Spackstor/Ant-Rot/AntRotAss.pdf

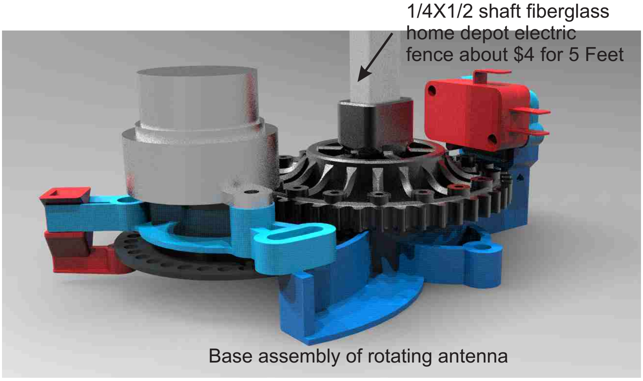
[picture p1: page 1]

Base assembly of rotating antenna

1/4X1/2 shaft fiberglass
home depot electric
fence about $4 for 5 Feet

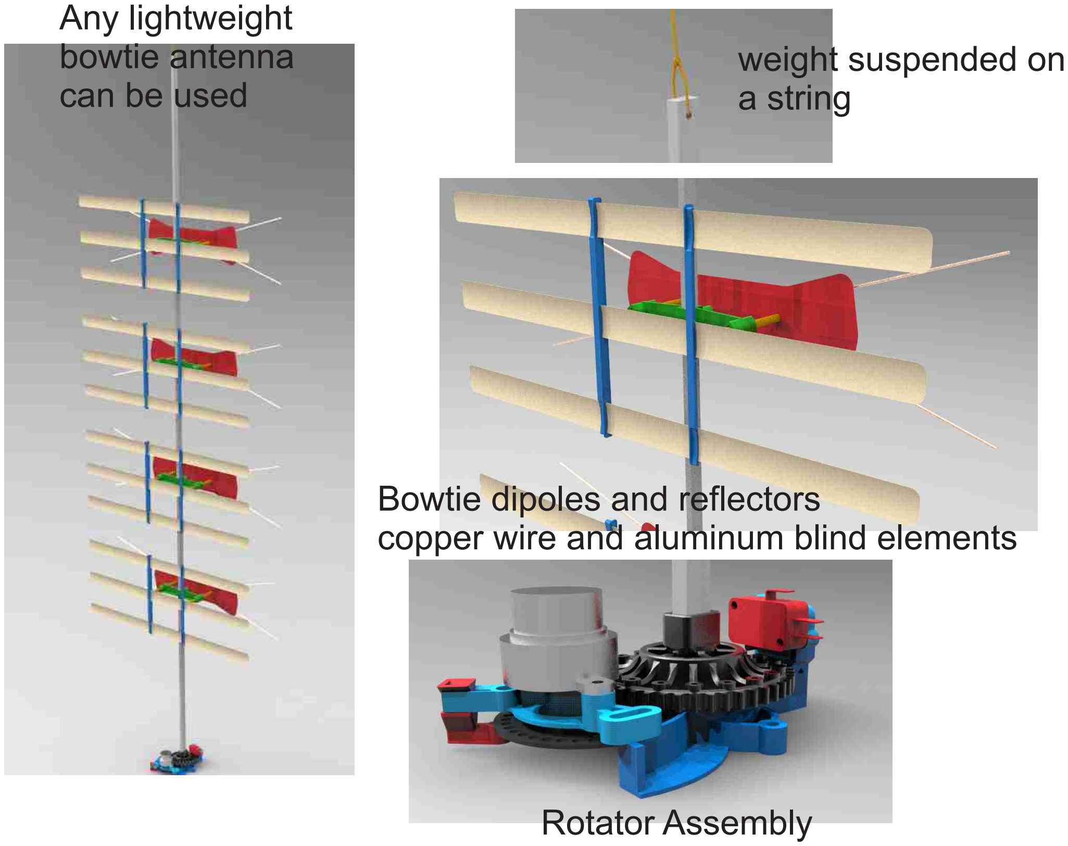
[picture p2: page 2]

Rotator Assembly

Bowtie dipoles and reflectors
copper wire and aluminum blind elements

weight suspended on
a string

Any lightweight
bowtie antenna
can be used

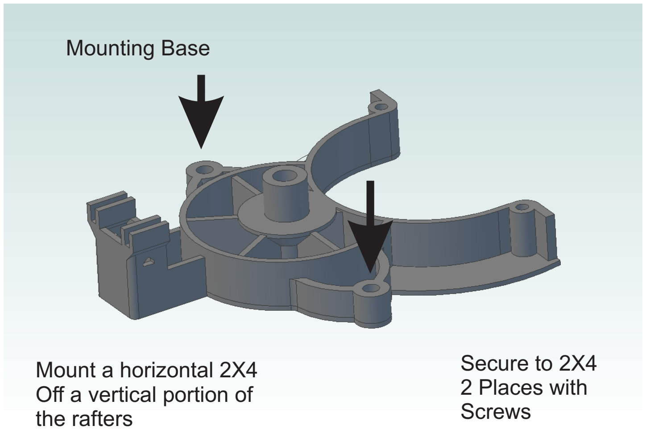
[picture p3: page 3]

Mounting Base

Mount a horizontal 2X4
Off a vertical portion of
the rafters

Secure to 2X4
2 Places with
Screws

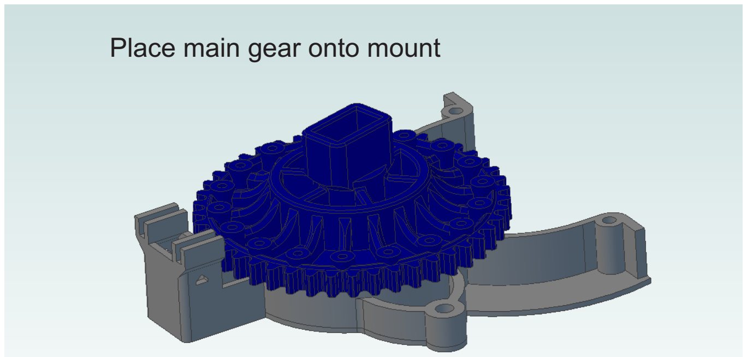
[picture p4: page 4]

Place main gear onto mount

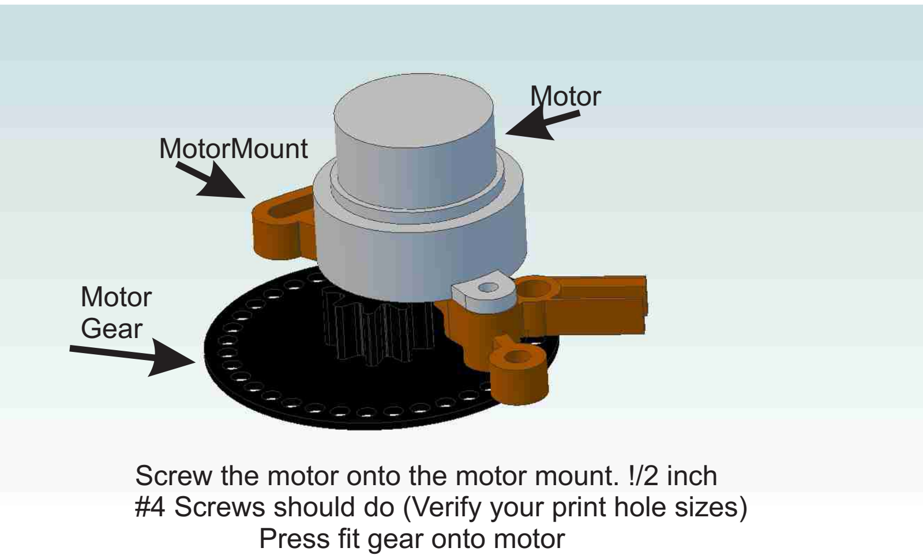
[picture p5: page 5]

Motor

MotorMount

Motor
Gear

Screw the motor onto the motor mount. !/2 inch #4 Screws should do (Verify your print hole sizes) Press fit gear onto motor

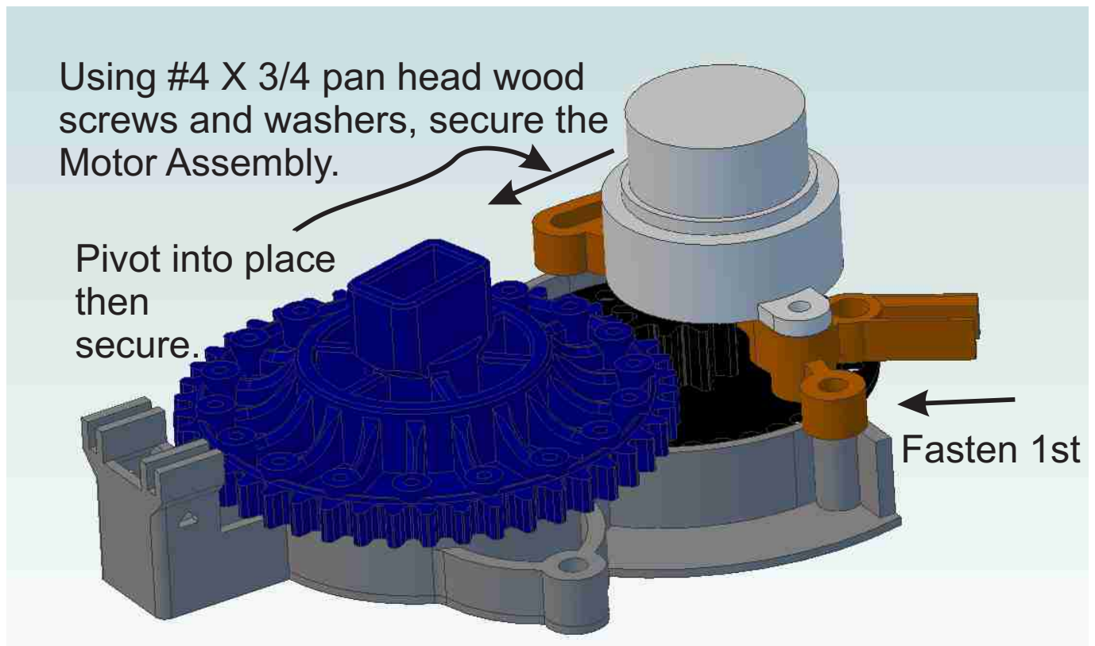
[picture p6: page 6]

Using #4 X 3/4 pan head wood screws and washers, secure the Motor Assembly.

Fasten 1st

Pivot into place
then
secure.

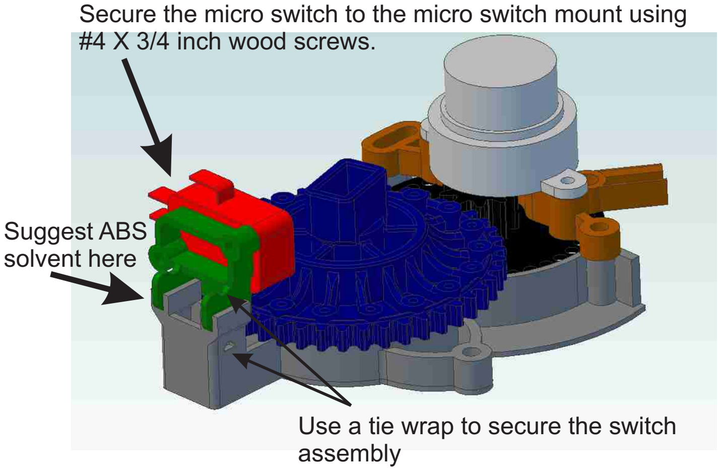
[picture p7: page 7]

Secure the micro switch to the micro switch mount using #4 X 3/4 inch wood screws.

Suggest ABS
solvent here

Use a tie wrap to secure the switch assembly

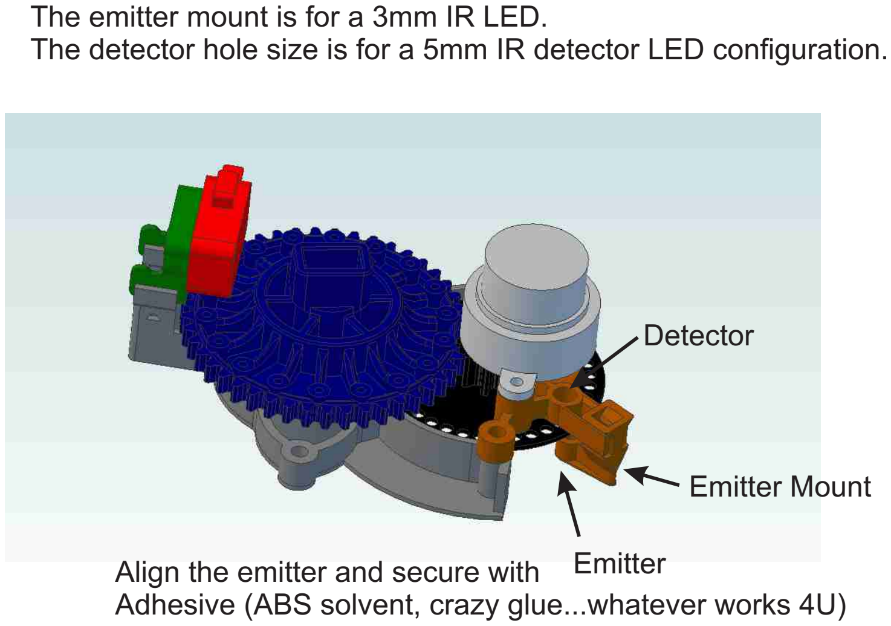
[picture p8: page 8]

Emitter Mount

The emitter mount is for a 3mm IR LED.
The detector hole size is for a 5mm IR detector LED configuration.

Detector

Align the emitter and secure with Emitter
Adhesive (ABS solvent, crazy glue...whatever works 4U)

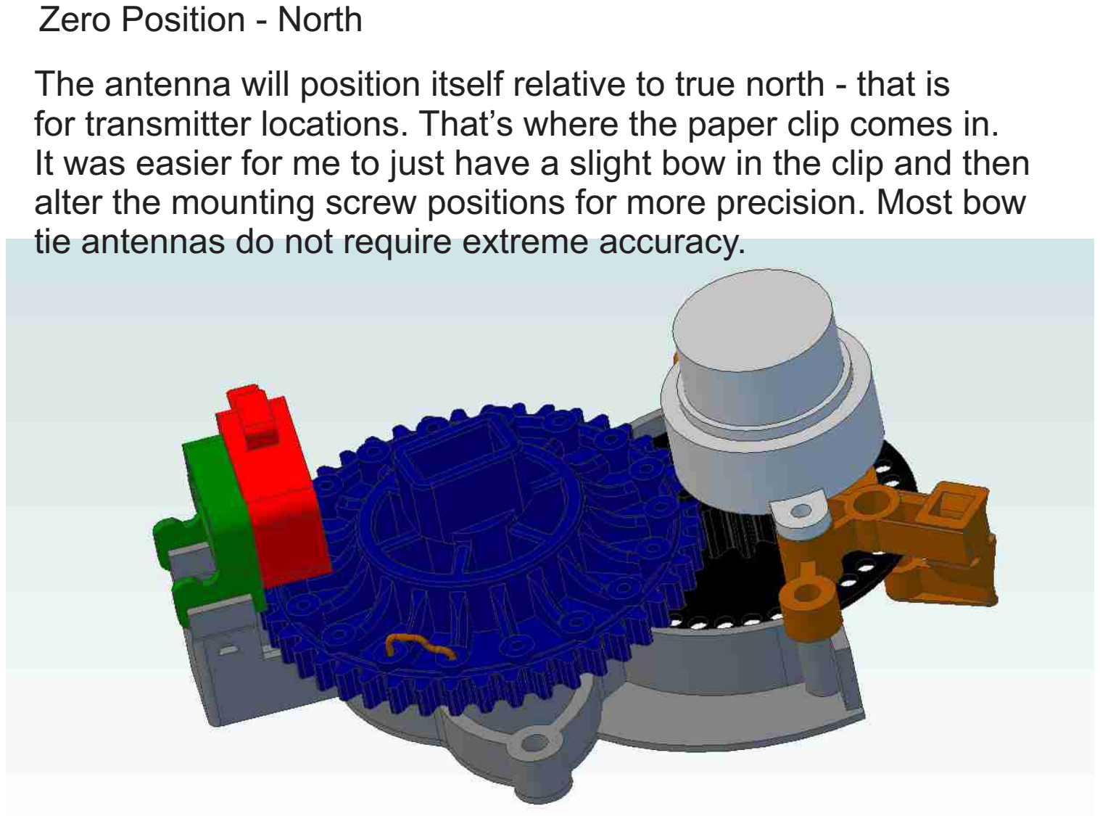
[picture p9: page 9]

Zero Position - North

The antenna will position itself relative to true north - that is
for transmitter locations. That’s where the paper clip comes in. It was easier for me to just have a slight bow in the clip and then alter the mounting screw positions for more precision. Most bow tie antennas do not require extreme accuracy.

Screw sizes will depend on your 3D print. So make first and get screws later. My setup is high density for strength, this makes part walls slightly larger and hole sizes smaller.

Depending on the nature of your set up some sanding or drilling may be required.

If you're an experienced 3D printer, you know this already.

For gears, I learnt a long time ago that perfect involutes require more development than they are worth so these parts are not that, but they work just fine.
