Spackstor/Ant-Rot/Browser Interface.pdf

This is the default page when the rotator first sets up It is set up for my location.

The information at the top tells you the antenna direction in degrees and any channels you may get from that direction.

The city buttons will turn the antenna toward the programmed cities.

To customize the program you will have to alter the city names and headings based on your location.

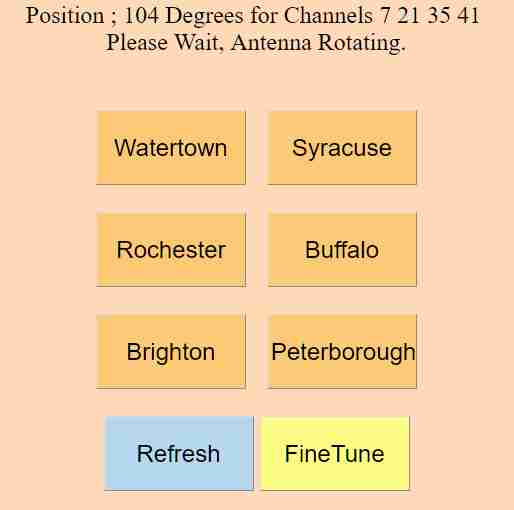
[picture p10: figure]

The refress button will refresh the screen once the antenna has arrived to the selected city. This will give you the channels listing for that heading.

When you press the
fine tune on the
previous screen, this
is what you get. 4
degree incremental
rotations are more
that incremental
enough for a bowtie
antenna.
Reset will cause the
antenna to rotate back
to zero and count back
out to the default
position in my case
Watertown.
The location button
brings you back to the
location screen.

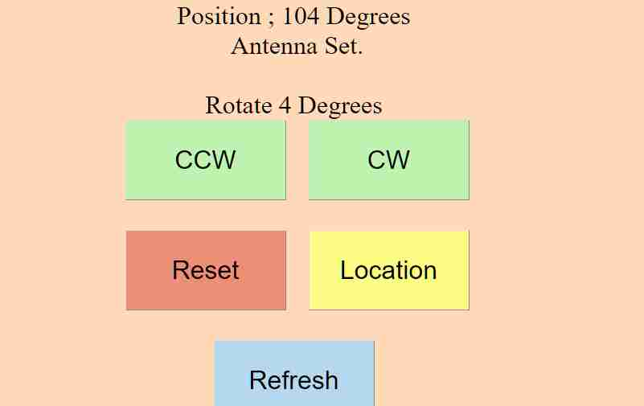
[picture p11: figure]
