Spackstor/Ant-Rot/WiringDiagram.pdf

## Rotator for Attic Antenna

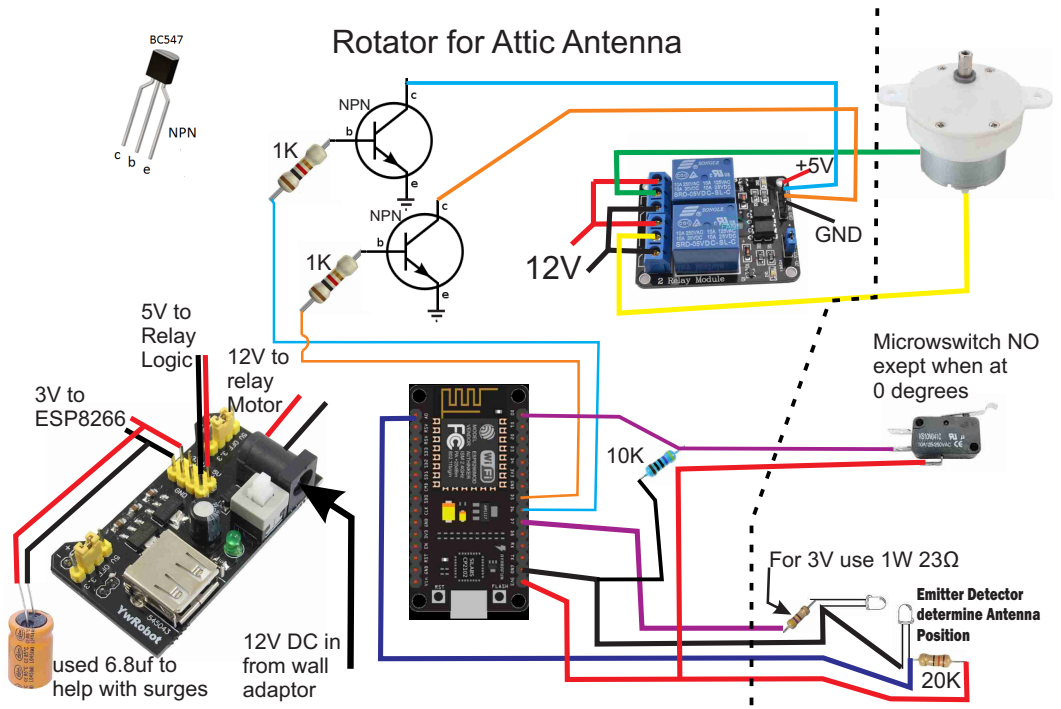
[picture p12: page 1]
NPN; Emitter Detector determine Antenna Position; For 3V use 1W 23Ω; GND; 12V DC in from wall adaptor; 12V to relay Motor; 5V to Relay Logic; 3V to ESP8266

Microwswitch NO
exept when at
0 degrees

used 6.8uf to
help with surges

For 3V use 1W 22Ω

GND

3.3V

A0

IR Emitter/LED

IR Detector

D7
GND

GND

3.3V
D0
Zero Position
Micro Switch 10K

Keeping resistors at connection (ESP8266) end of cable harnesses reduces amount of wire required.

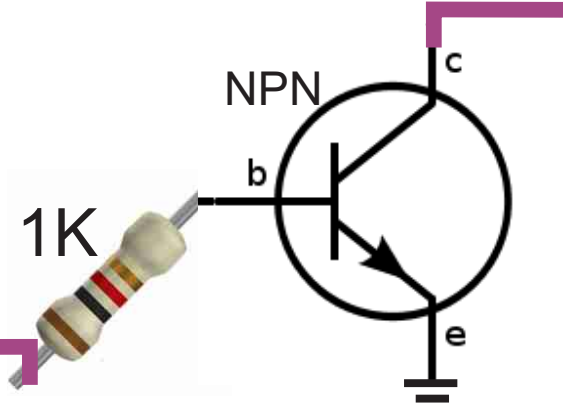
[picture p13: figure]
NPN

to relay logic

to ESP8266

20 K
